weisrc/project-wrover/images/avr_schematic.png

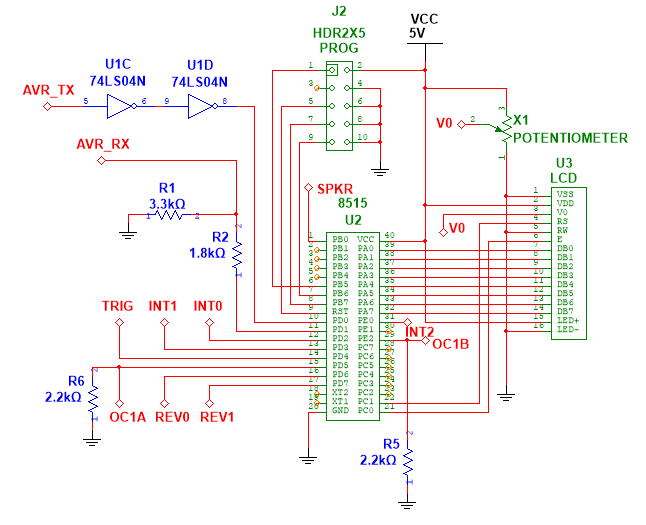
images/avr_schematic.png
