weisrc/project-wrover/images/esp_schematic.png

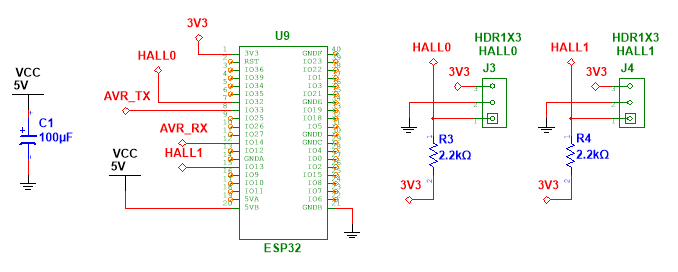
images/esp_schematic.png
