weisrc/project-wrover/images/motor_logic_schematic.png

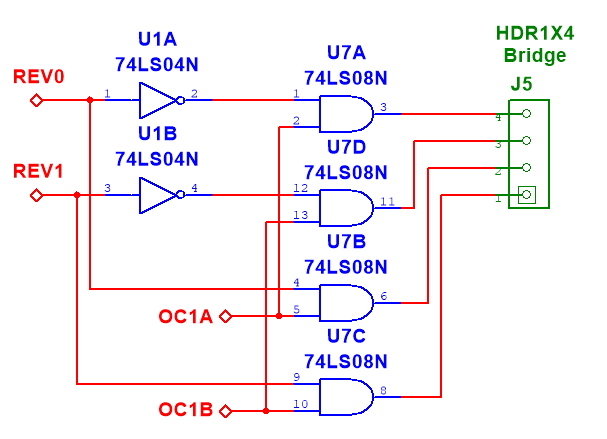
images/motor_logic_schematic.png
