weisrc/project-wrover/images/sonar_schematic.png

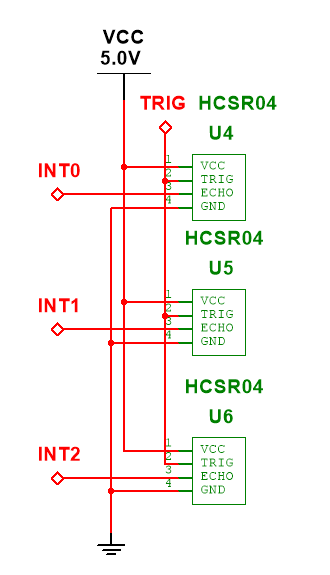
images/sonar_schematic.png
