weisrc/project-wrover/images/web_camera_view.png

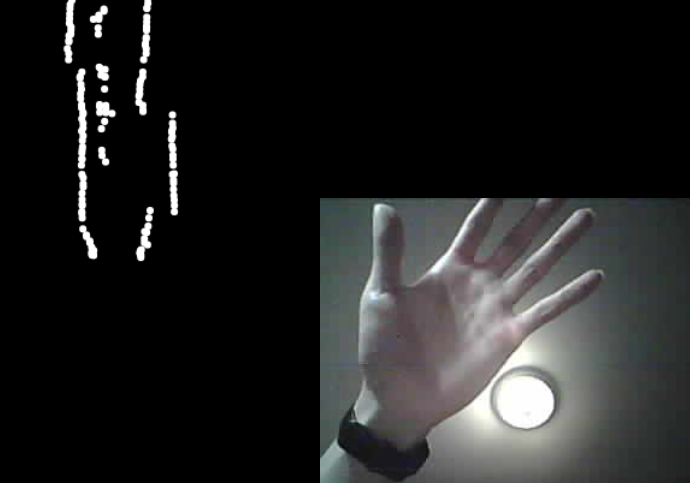
images/web_camera_view.png
