weisrc/project-wrover/images/web_sonar_map.png

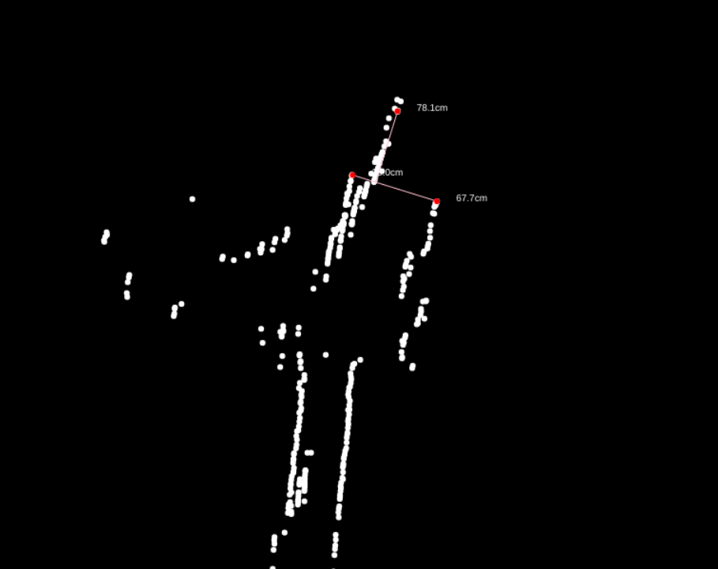
images/web_sonar_map.png
