weisrc/project-wrover/images/web_setup_scan.png

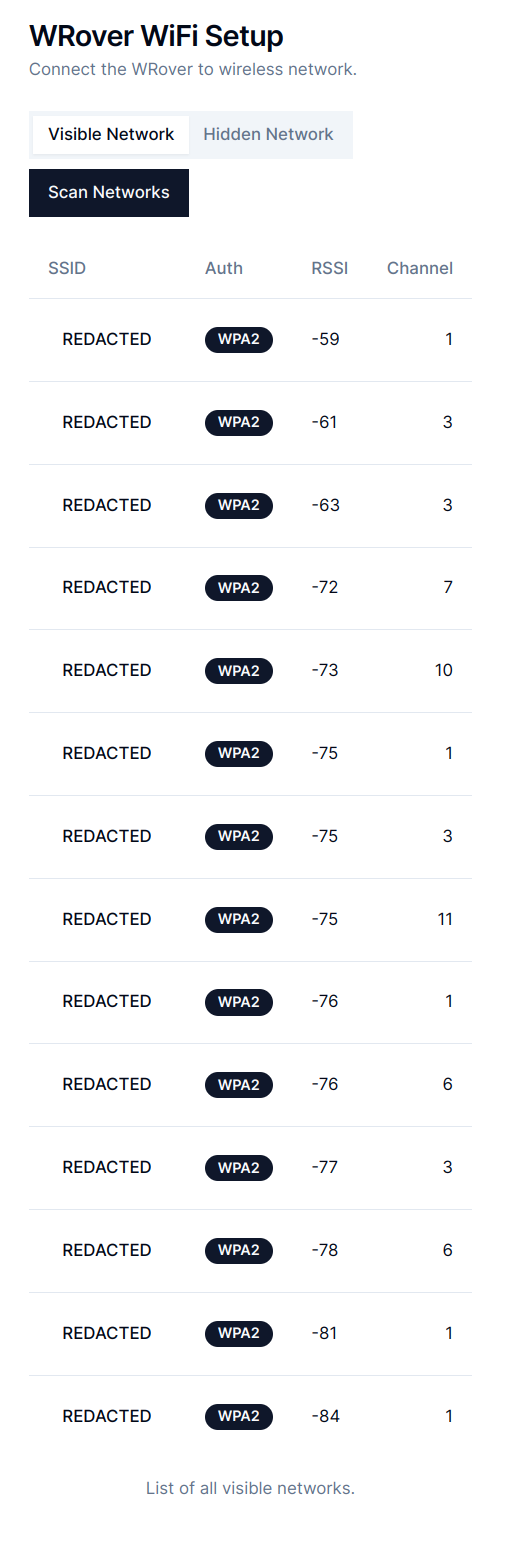
images/web_setup_scan.png
