weisrc/project-wrover/(list of files, drawings)

Other design files:
pcb/multisim/schematic.ms14
