weisrc/project-wrover/esp/src/camera_setup.h

/**
 * @author Wei
 * Generic camera setup function
 */

#pragma once
#include <Arduino.h>
#include <camera_pins.h>
#include <esp_camera.h>

#include "globals.h"

/**
 * Camera setup function
 */
void cameraSetup()
{
  camera_config_t config;
  config.ledc_channel = LEDC_CHANNEL_0;
  config.ledc_timer = LEDC_TIMER_0;
  config.pin_d0 = Y2_GPIO_NUM;
  config.pin_d1 = Y3_GPIO_NUM;
  config.pin_d2 = Y4_GPIO_NUM;
  config.pin_d3 = Y5_GPIO_NUM;
  config.pin_d4 = Y6_GPIO_NUM;
  config.pin_d5 = Y7_GPIO_NUM;
  config.pin_d6 = Y8_GPIO_NUM;
  config.pin_d7 = Y9_GPIO_NUM;
  config.pin_xclk = XCLK_GPIO_NUM;
  config.pin_pclk = PCLK_GPIO_NUM;
  config.pin_vsync = VSYNC_GPIO_NUM;
  config.pin_href = HREF_GPIO_NUM;
  config.pin_sccb_sda = SIOD_GPIO_NUM;
  config.pin_sccb_scl = SIOC_GPIO_NUM;
  config.pin_pwdn = PWDN_GPIO_NUM;
  config.pin_reset = RESET_GPIO_NUM;
  config.xclk_freq_hz = 20e6;
  config.frame_size = FRAMESIZE_QVGA;
  config.pixel_format = PIXFORMAT_JPEG;
  config.grab_mode = CAMERA_GRAB_WHEN_EMPTY;
  config.fb_location = CAMERA_FB_IN_PSRAM;
  config.jpeg_quality = 18;
  config.fb_count = 1;

  if (PWDN_GPIO_NUM != -1)
  {
    pinMode(PWDN_GPIO_NUM, OUTPUT);
    digitalWrite(PWDN_GPIO_NUM, LOW);
  }

  esp_err_t err = esp_camera_init(&config);

  if (err == ESP_OK)
  {
    cameraOk = true;
  }

  sensor_t *s = esp_camera_sensor_get();

  s->set_vflip(s, true);
  s->set_hmirror(s, true);
}
