weisrc/project-wrover/(commit log)

2024-02-13 add buttons
2024-02-13 add camera setup
2024-02-21 add multiisim schematic
    [schematic.ms14]
2024-02-22 add ultrasound to schematic
    [schematic.ms14]
2024-02-27 ultrasonic data to websocket
2024-02-27 add motor control
2024-03-01 fix remote connect button
2024-03-01 add hall sensor broadcast
2024-03-05 use seperate websocket for camera
2024-03-05 use separate camera websocket and debounce hall
2024-03-05 add sonar rays
2024-03-08 fix serial lcd corruption
    [avr_serial.h, main.cpp, wifi_connection.h]
2024-03-08 update camera clock
2024-03-08 add keyboard motor control
2024-03-12 signed motor control
2024-03-12 fix signed motor control issues
2024-03-12 signed motor controls
2024-03-12 add smooth motor control to prevent spikes in current
    [main.asm]
2024-03-15 fix typo, send camera only on request
    [camera_setup.h, camera_stream.h, globals.h, handle_request.h, locomotion.h, main.asm, main.cpp]
2024-03-15 send camera capture requests
2024-03-15 send camera capture to one socket
2024-03-15 handle hall motor direction
2024-03-19 add camera ok status
2024-03-21 locomotion reverse after no motor hall change
    [locomotion.h]
2024-03-22 remove motor will reverse logic + speedup motor smoothing
    [locomotion.h]
2024-03-22 canvas camera follow vehicule
2024-03-22 predict when wheel reversed
    [locomotion.h, main.cpp]
2024-03-26 better camera
2024-03-26 set camera frame size command
2024-03-27 mavg sonars, locomotion reply instead of braodcast
2024-04-01 ack serial wip, issue: acking to acks even with seemingly proper tracking
    [avr_serial.h, main.asm, main.cpp]
2024-04-03 fix memory leak for promises
    [logger.h, main.cpp, promise.h, wifi_checks.h]
2024-04-05 add message queue, make channel safer, odd parity, fix tx timeout on avr
    [avr_serial.h, channel.h, globals.h, locomotion.h, logger.h, main.asm, main.cpp, message_queue.h]
2024-04-05 avr lcd print hex
2024-04-05 refactor ack serial control flow
2024-04-05 add pcb and update schematic
    [schematic.ms14]
2024-04-06 write readme
    [schematic.ms14]
2024-04-08 add vec2 test code and fix vec2 mult typo
    [promise_test.h, unity_config.cpp, vec2.h, vec2_test.h]
2024-04-08 add esp to schematic
    [schematic.ms14]
2024-04-09 add esp 32 to pcb
    [schematic.ms14]
2024-04-15 add startup and motor move sound
2024-04-16 update schematic
    [schematic.ms14]
2024-04-16 pcb mostly done
    [schematic.ms14]
2024-04-16 small adjustments
    [schematic.ms14]
2024-04-17 adjust pcb
    [schematic.ms14]
2024-04-19 player set only if idle, add tunes sonar sounds
2024-04-24 fix missing pulldown, flip lcd two pins
    [schematic.ms14]
2024-04-26 fix schematic, reorder asm init, flip tx, rx on esp
    [schematic.ms14]
2024-04-26 change pull down to pull up on hall
    [schematic.ms14]
2024-04-26 fix multisim and ultiboard
    [schematic.ms14]
2024-05-02 fix schematics
    [schematic.ms14]
2024-05-06 rotate camera, process locomotion time, reorder avr init
2024-05-10 better navigation logic with sonars
2024-05-10 add more weight to sonar score
2024-05-17 fix navigation vec bug
    [navigation.h]
2024-05-17 make schematic more pretty
    [schematic.ms14]
2024-05-21 add arm docker
2024-05-21 fix camera stream getting stuck
